Lisyea/Pulse_Oximeter/README.md

# Pulse Oximeter

This device can measure pulse rate and oxyhemoglobin saturation by detecting the fingertip.

## Project Video

https://youtu.be/vuH5nB1Igv4
