Lisyea/Pulse_Oximeter/作品照片/IMG_0723.JPG

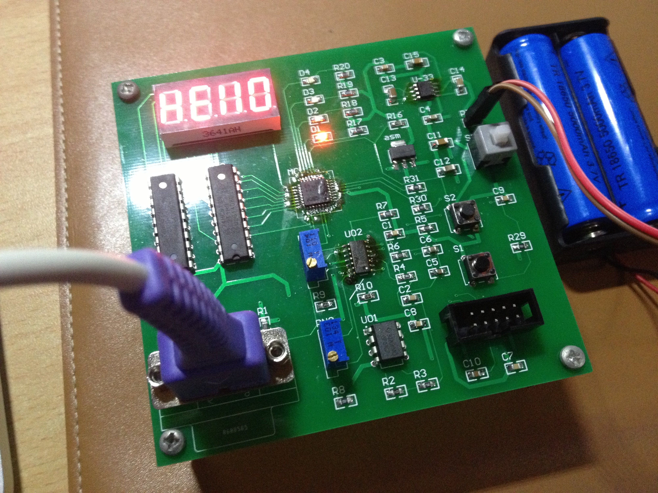
作品照片/IMG_0723.JPG
