Lisyea/Pulse_Oximeter/作品照片/IMG_0762.JPG

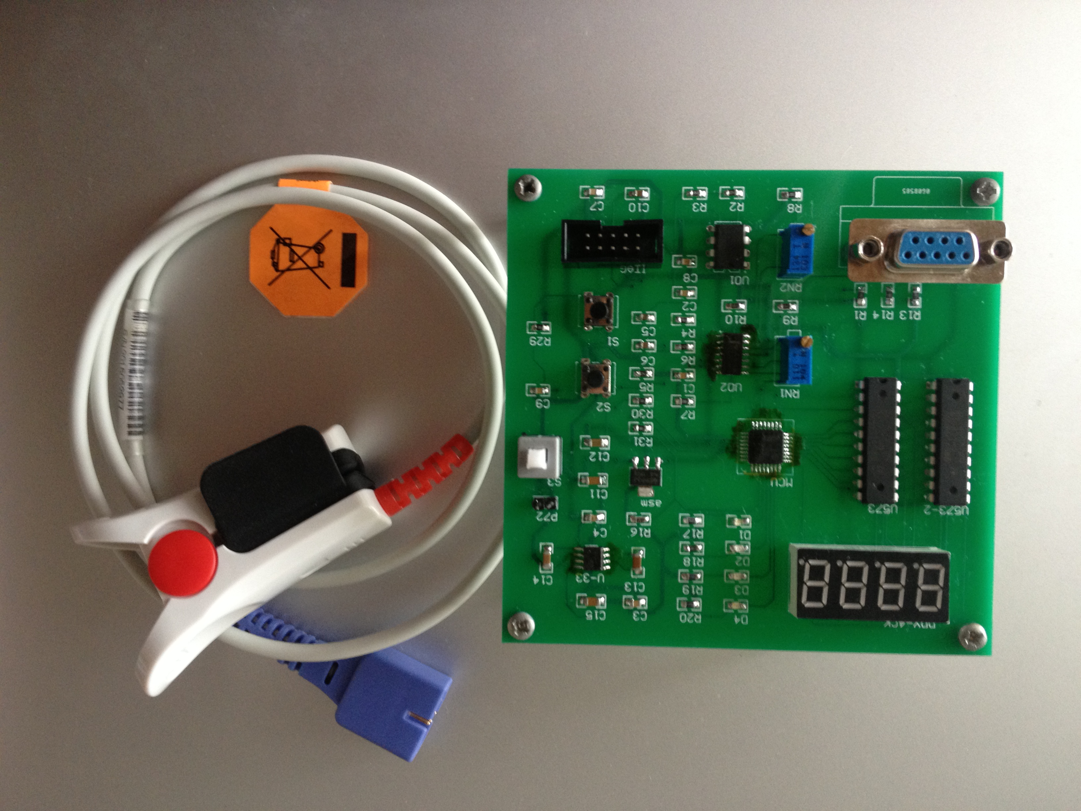
作品照片/IMG_0762.JPG
