Lisyea/Pulse_Oximeter/(list of files, cad)

Other CAD files:
Keil/XYMB/XYMB0.OBJ
