Lisyea/Pulse_Oximeter/PCB/design/PCB.pdf

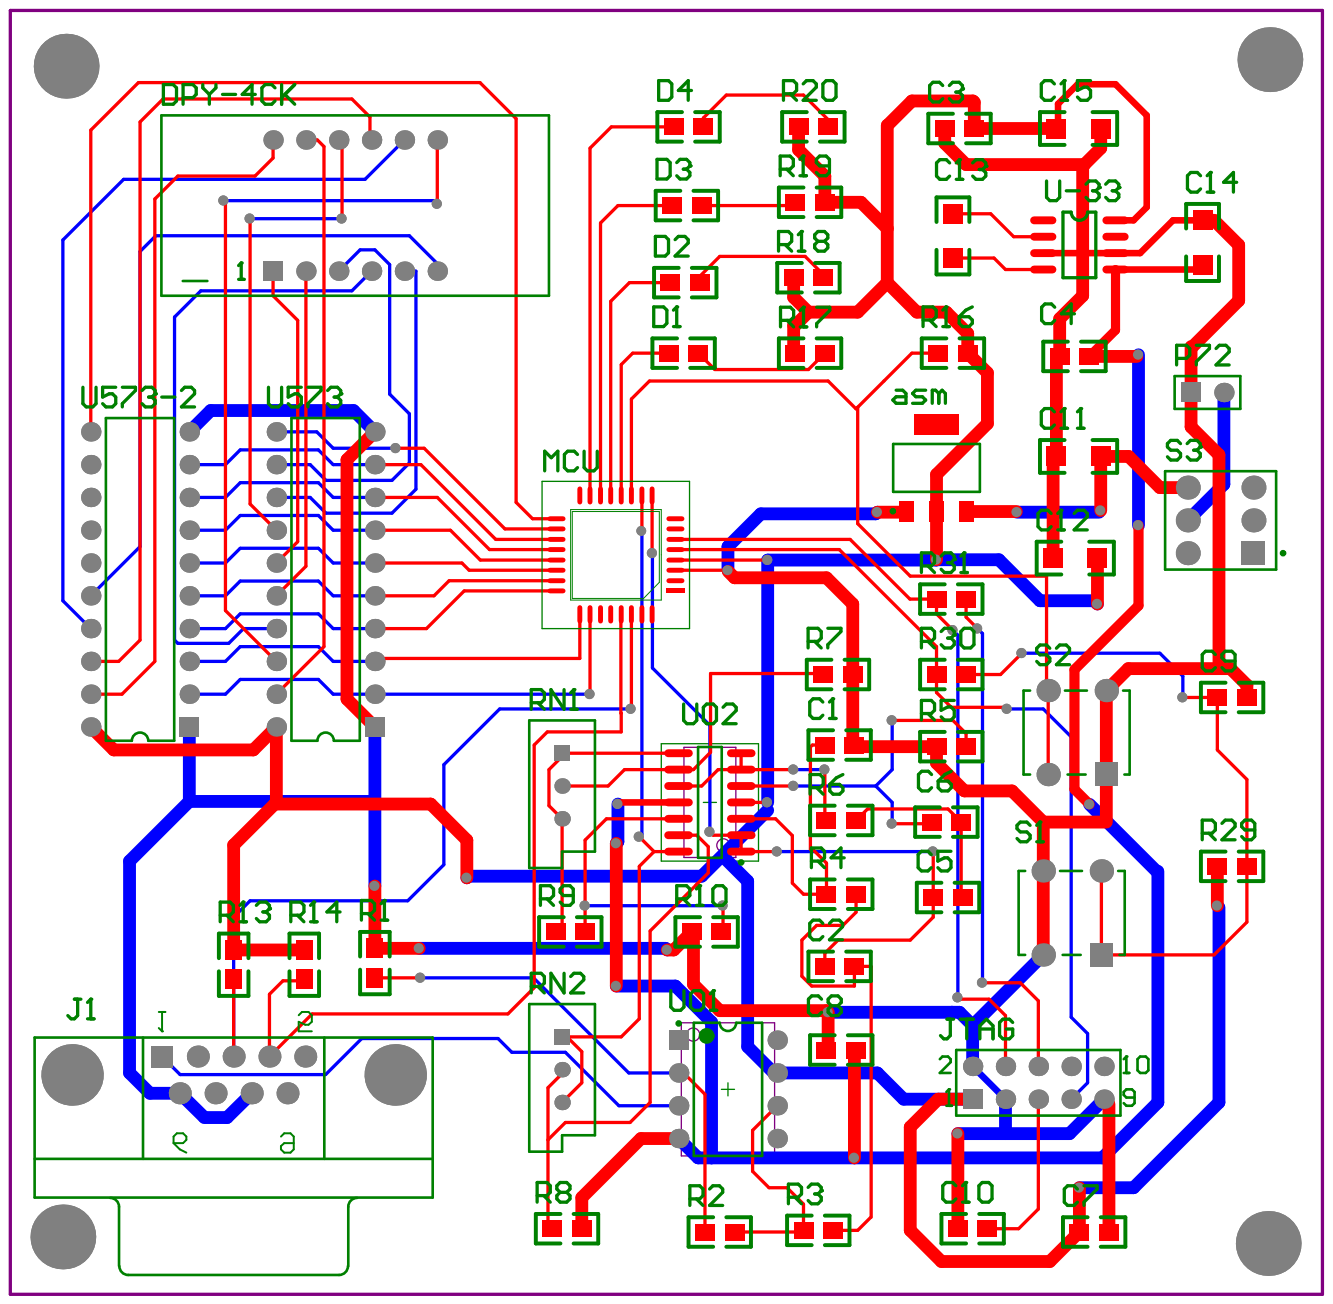
[picture p29: page 1]

Comment | Description | Designator | Footprint | LibRef | Quantity
ASM1117 | 3.3V稳压芯片 | asm | SOT-223 | ASM1117 | 1
Cap | Capacitor | C1, C2, C3, C4, C5, C6, C7, C8, C9, C10 | 0805 | Cap | 10
Cap | Capacitor | C11, C12, C13, C14, C15 | 1206 | Cap | 5
LED2 | Typical RED, GREEN, YELLOW, AMBER GaAs LED | D1, D2, D3, D4 | 0805 | LED2 | 4
DPY-4CK | 共阴4位数码管 | DPY-4CK | DYP-4BIT | DPY-4CK | 1
D Connector 9 | Receptacle Assembly, 9 Position, Right Angle | J1 | DSUB1.385-2H9 | D Connector 9 | 1
Header 5X2 | Header, 5-Pin, Dual row | JTAG | HDR2X5 | Header 5X2 | 1
C8051F310 | | MCU | LQFP-32 | C8051F310/2/4_361/4/6 /8 | 1
Header 2 | Header, 2-Pin | P72 | HDR1X2 | Header 2 | 1
Res2 | Resistor | R1, R2, R3, R4, R5, R6, R7, R8, R9, R10, R13, R14, R16, R17, R18, R19, R20, R29, R30, R31 | 0805 | Res2 | 20
RPot | Potentiometer | RN1, RN2 | VR5 | RPot | 2
K1 | | S1, S2 | KEY1 | K1 | 2
SW-DPDT | Double-Pole, Double-Throw Switch | S3 | DPDT-6 | SW-DPDT | 1
OP-07 | | U01 | DIP-8 | OP-07 | 1
TLC2274 | | U02 | SOP-14N | LM324 | 1
SN74HC573N | Octal D-Type Transparent Latch with 3-State Outputs | U573, U573-2 | N020D | SN74HC573N | 2
TC7662ACPA | Super Charge Pump DC-U-33 | | S O-8 | TC7662AC PA | 1
