Lisyea/Pulse_Oximeter/PCB/design/design01_new.pdf

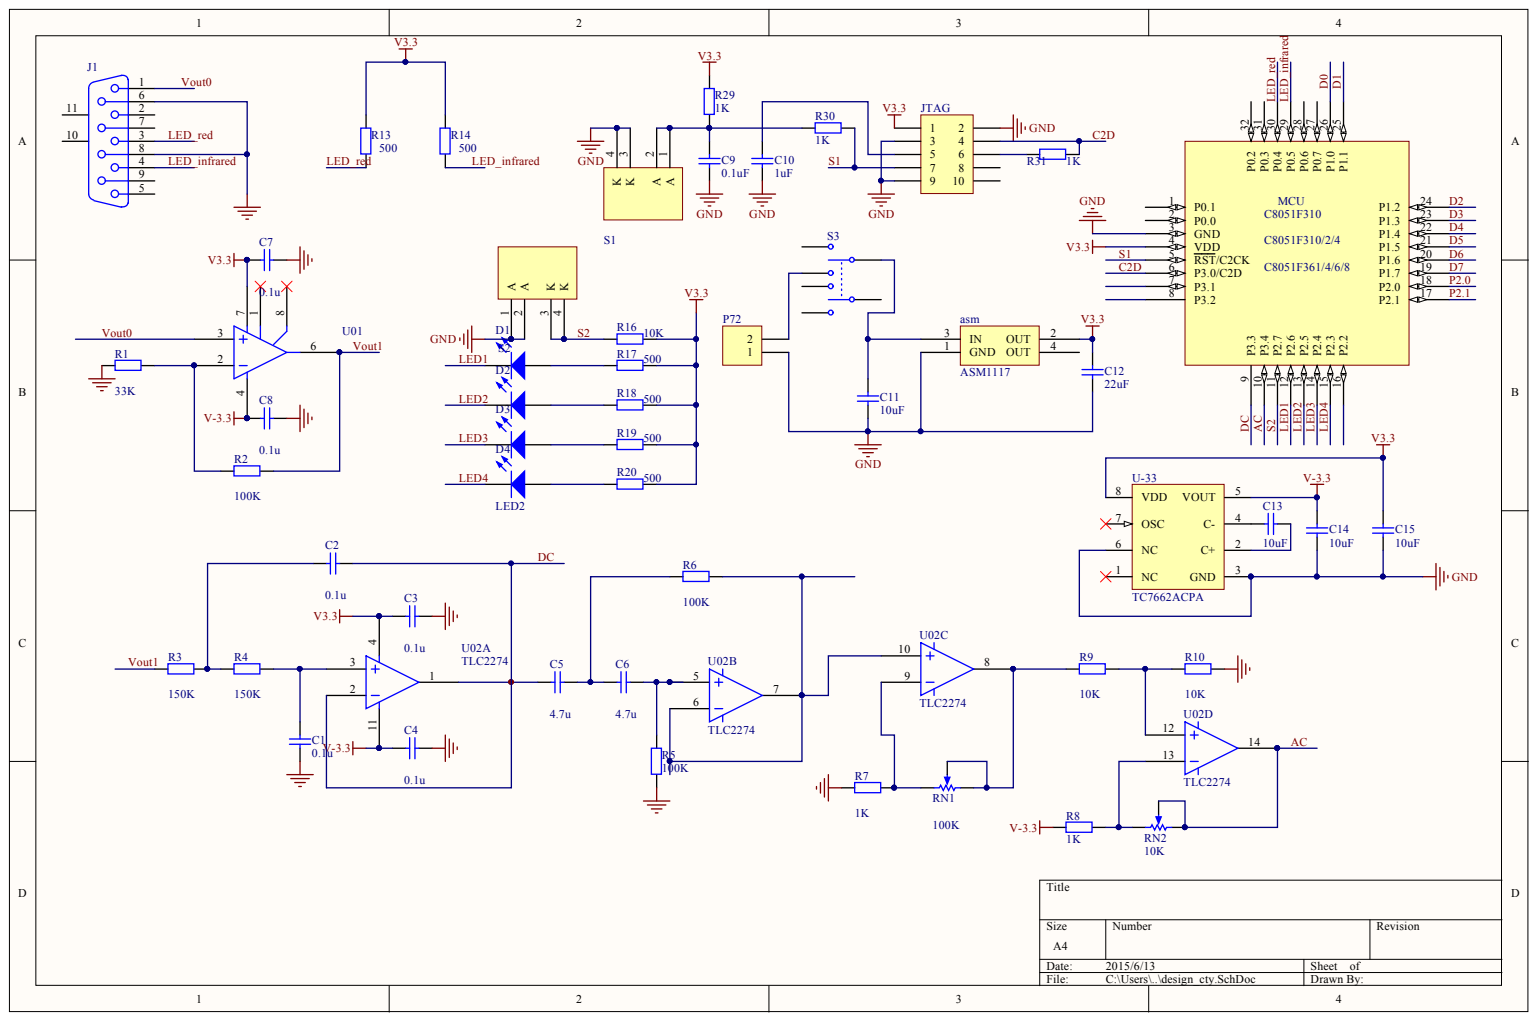
[picture p30: page 1]

OSC 7

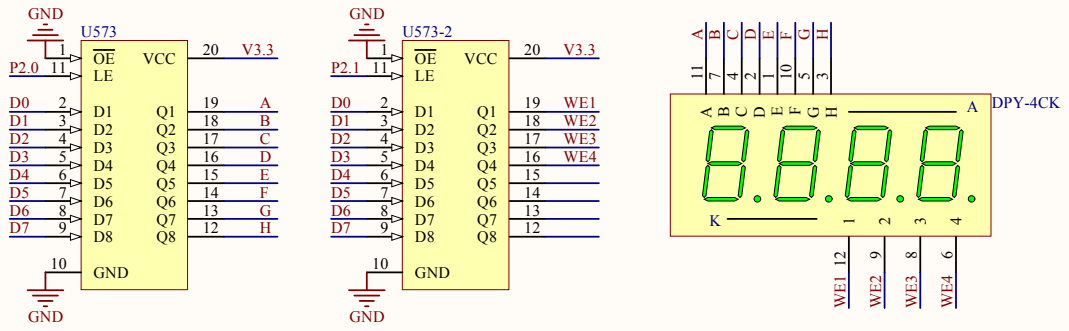
[picture p31: page 2]
