Lisyea/Pulse_Oximeter/PCB/design/PCB_design01.pdf

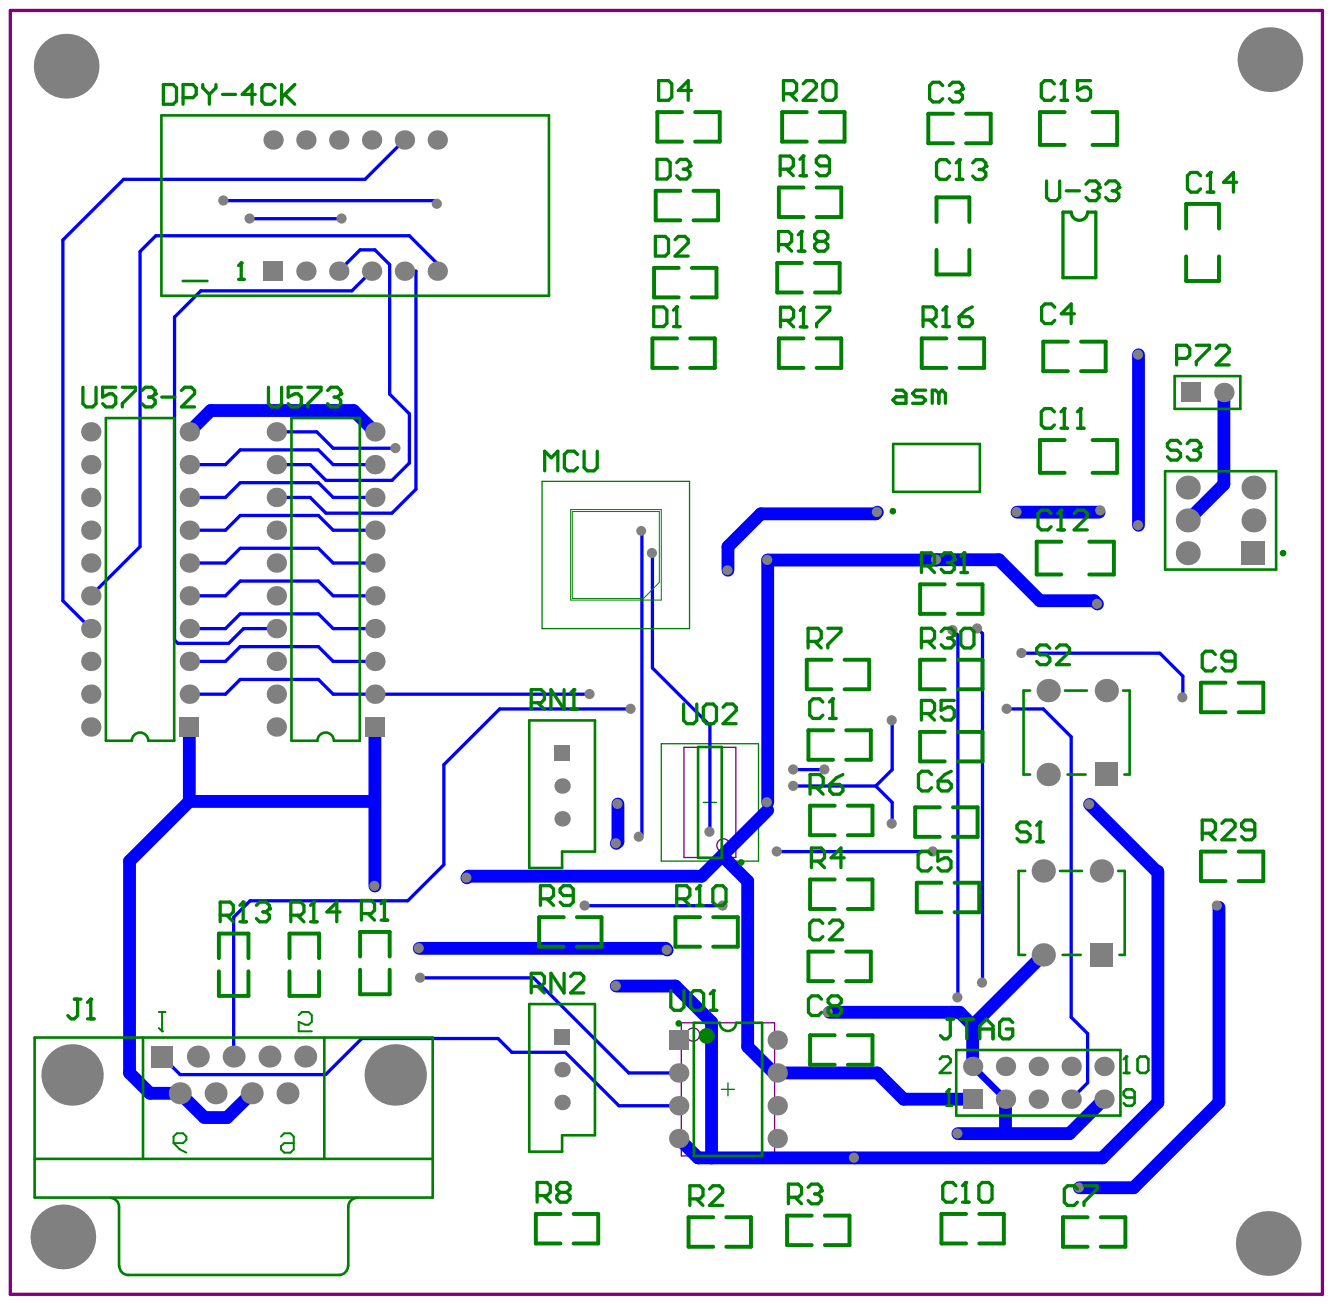
[picture p32: page 1]
