Lisyea/Pulse_Oximeter/(list of files, drawings)

Other design files:
PCB/design/design01.PrjPcb
PCB/design/design_cty.SchDoc
PCB/design/PCB_design01.PcbDoc
PCB/design/Schlib1.SchLib
PCB/design/Sheet2.SchDoc
